arber333/Ampera-inverter-driver-interface/signals.jpg

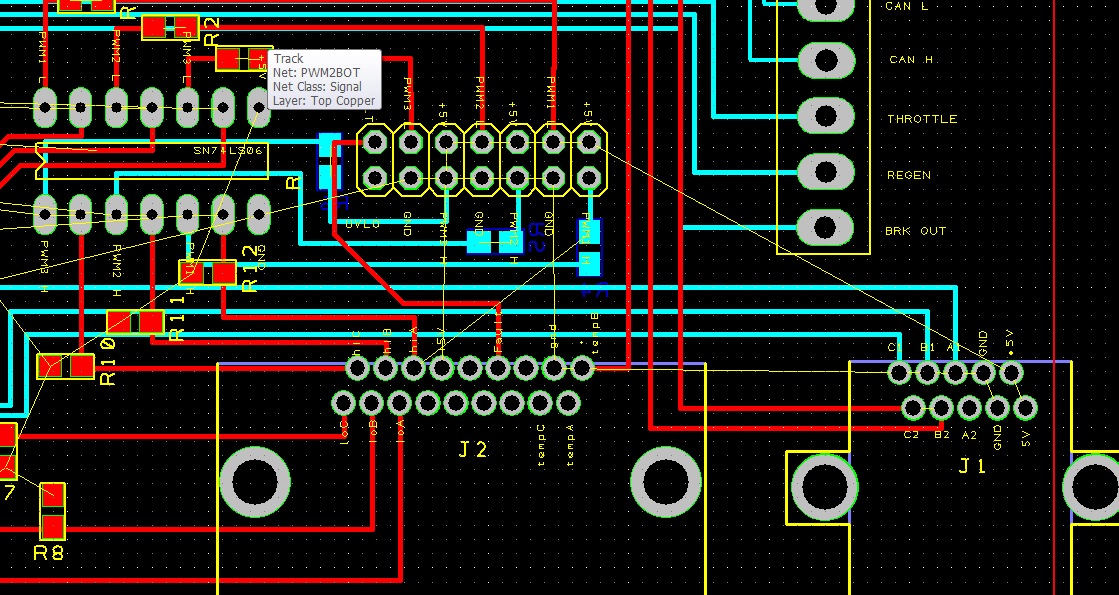
signals.jpg
