arber333/Ampera-inverter-driver-interface/signals2.jpg

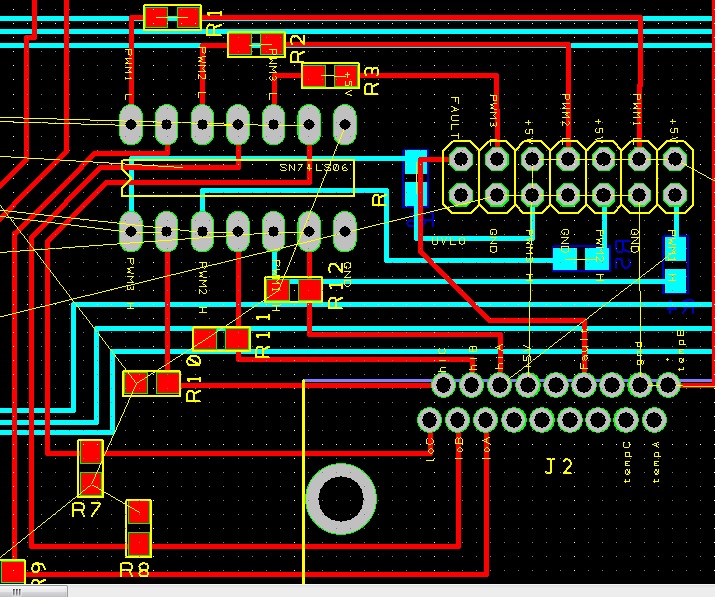
signals2.jpg
