arber333/Ampera-inverter-driver-interface/simple V2.jpg

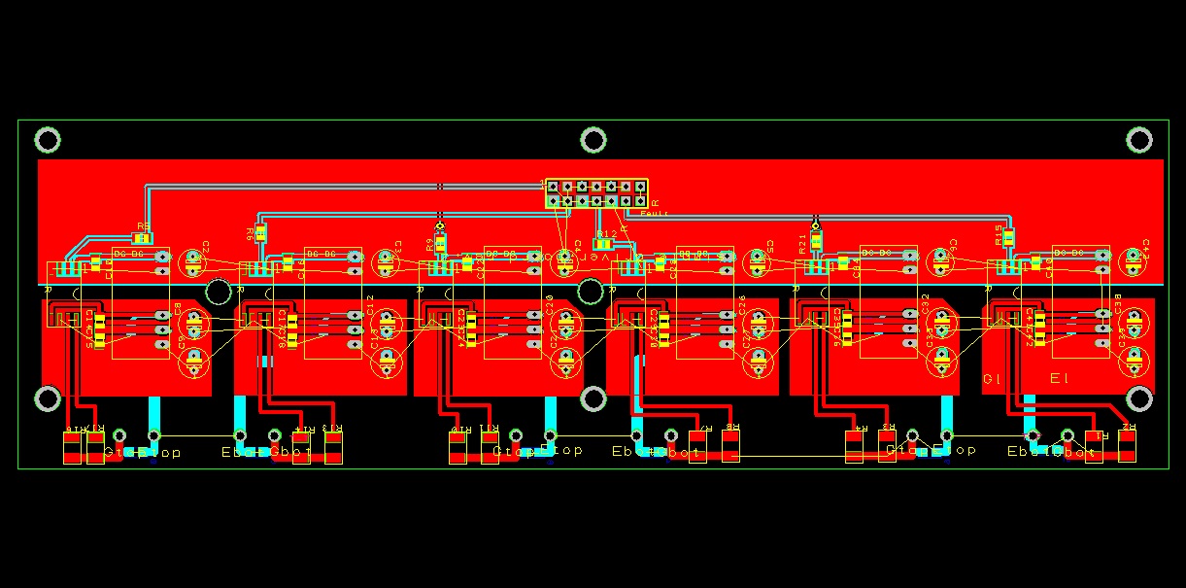
simple V2.jpg
