arber333/Ampera-inverter-driver-interface/translate PCB rev 2_3 - PCB.pdf

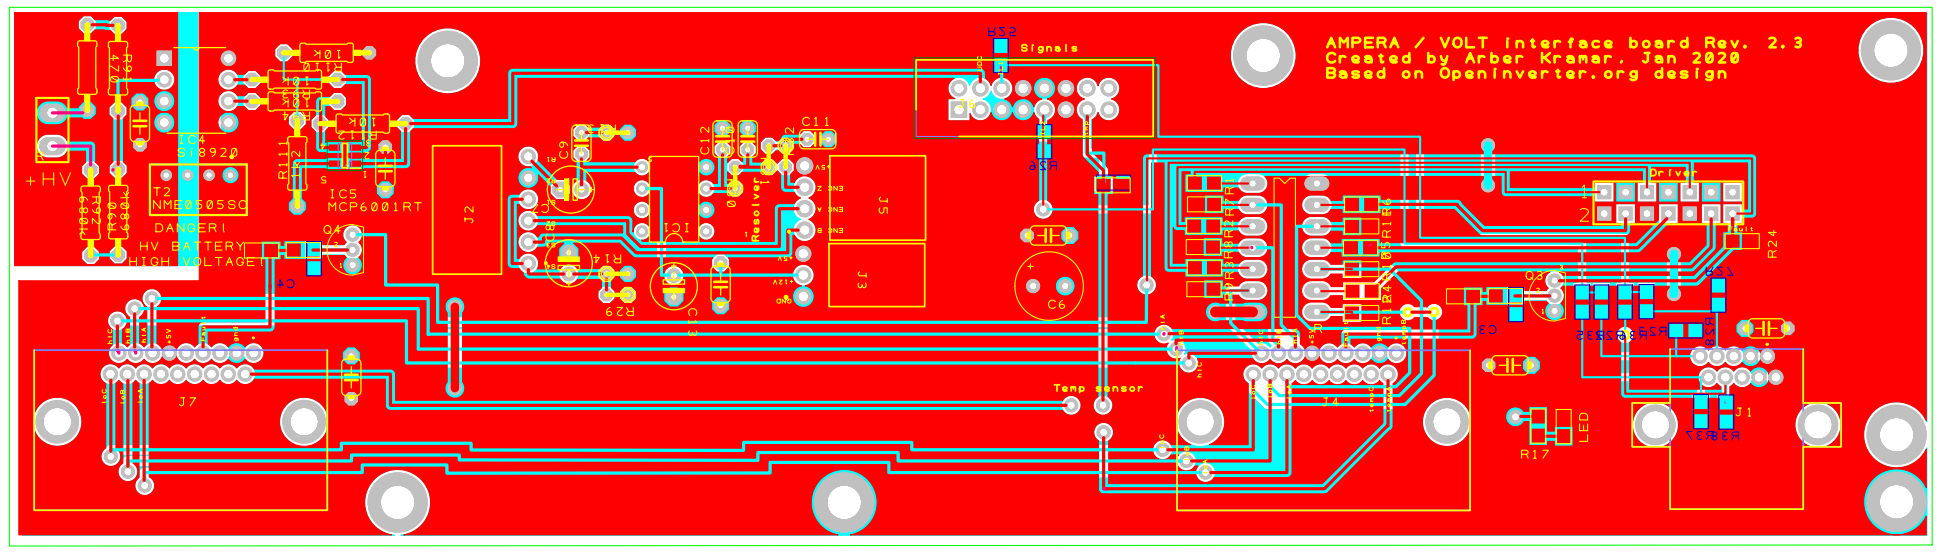
[picture p9: page 1]
