arber333/Ampera-inverter-driver-interface/lebowski interface board johannes - PCB.pdf

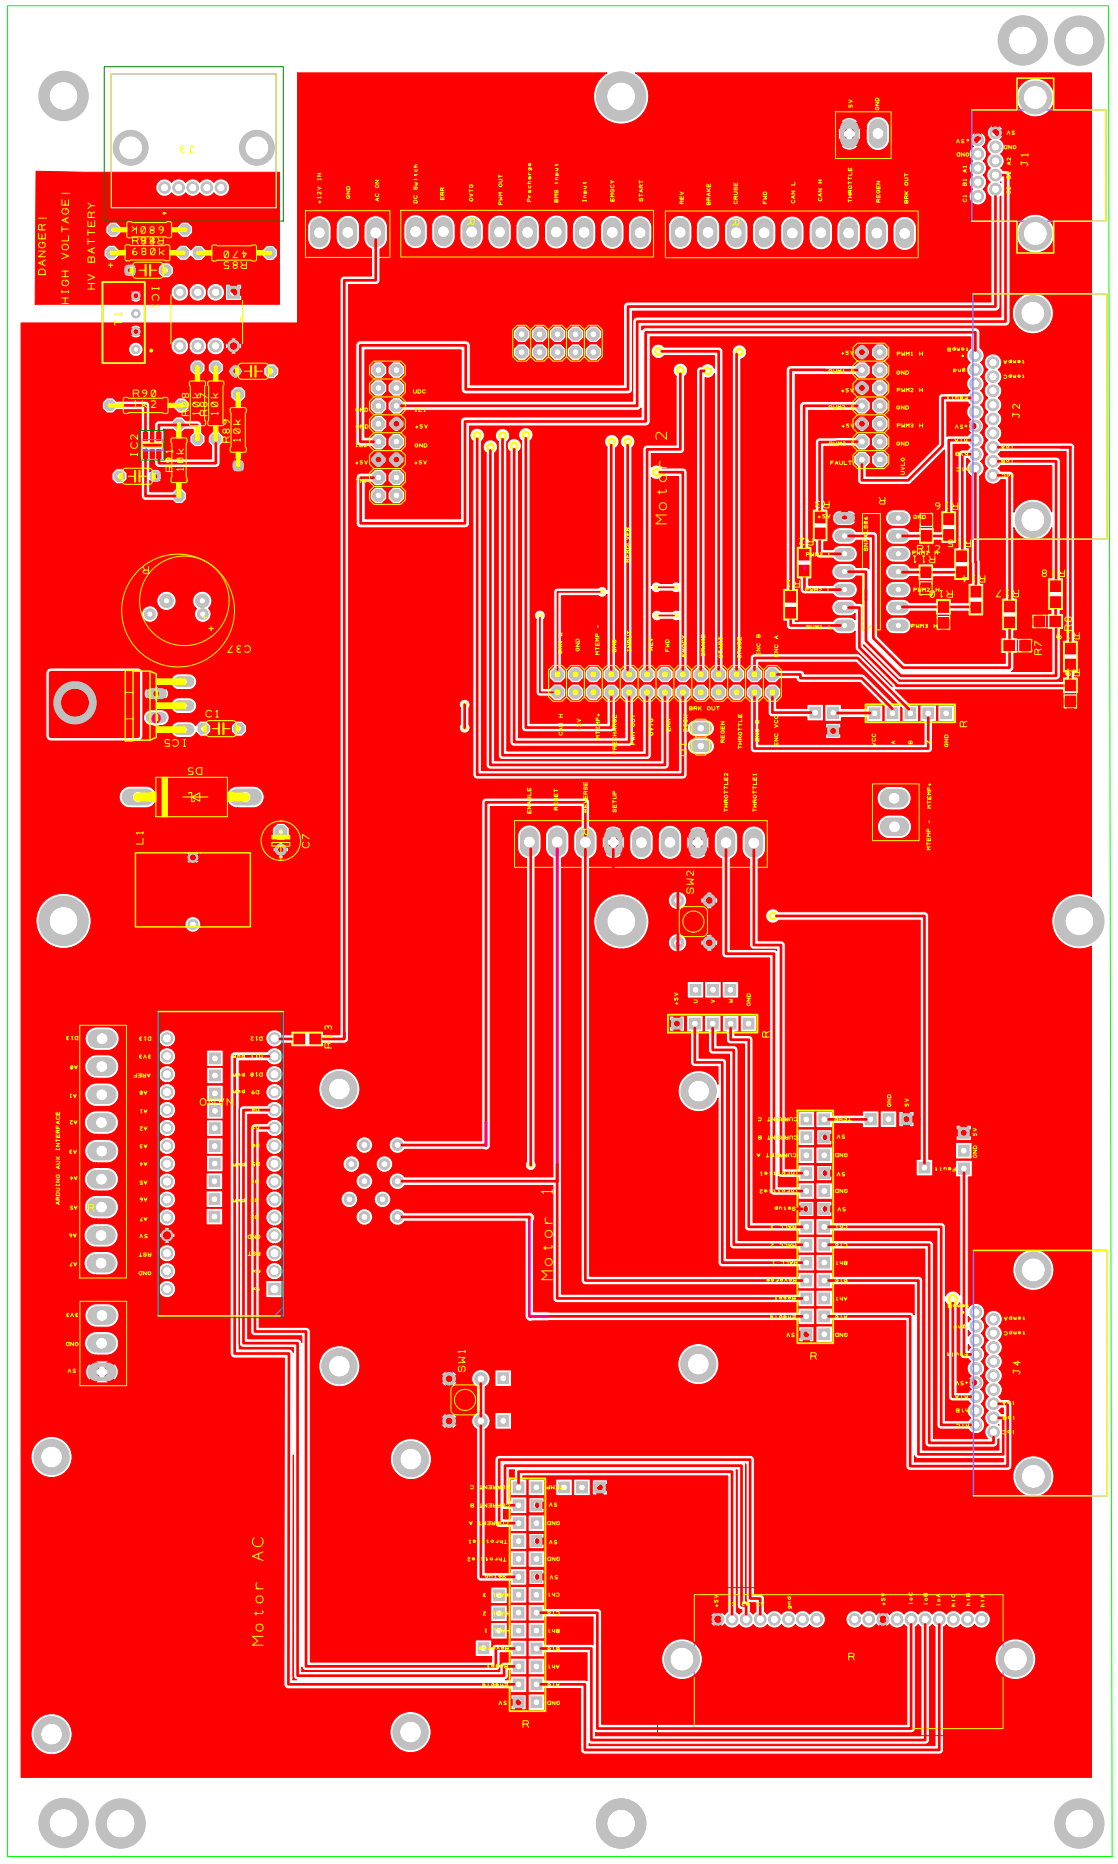
[picture p10: page 1]
