arber333/Ampera-inverter-driver-interface/lebowski interface board johannes - PCBb.pdf

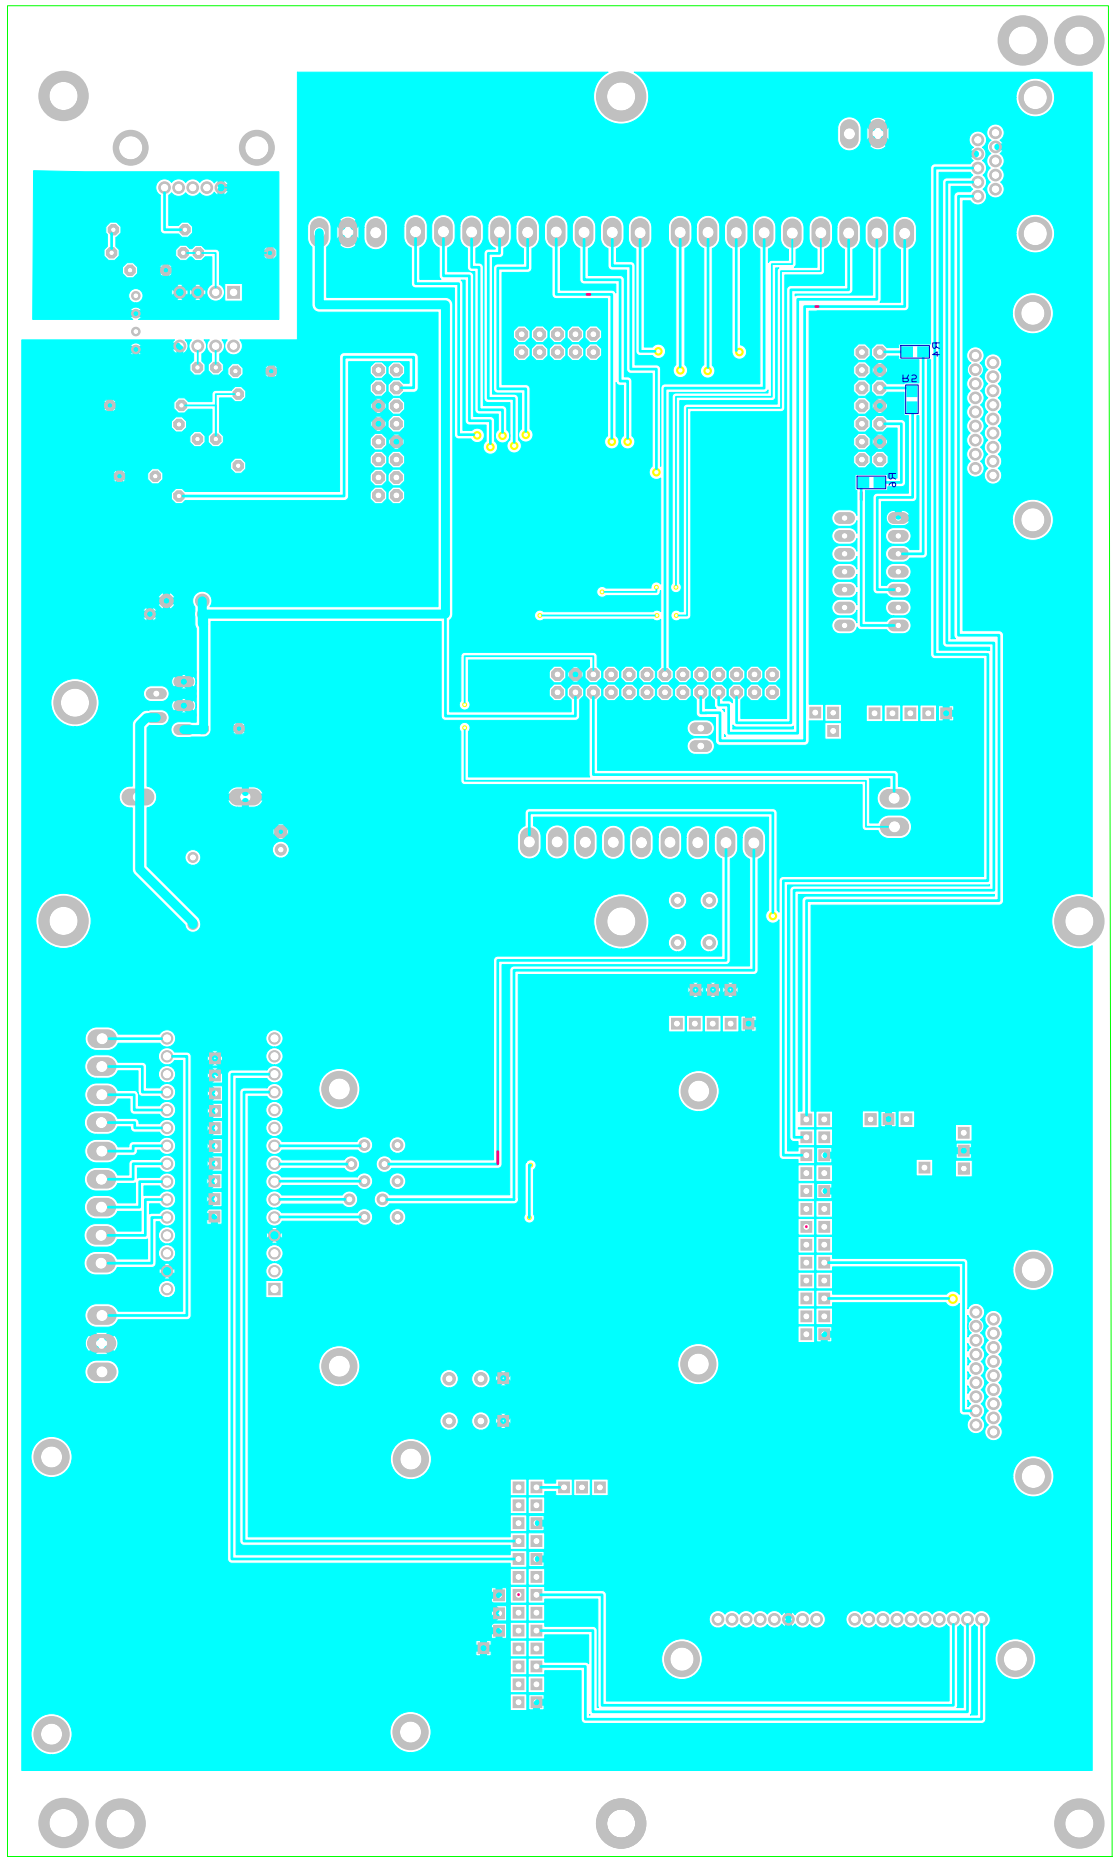
[picture p11: page 1]
