arber333/Ampera-inverter-driver-interface/(list of files, drawings)

Other design files:
lebowski interface board johannes.pcb
translate PCB rev 2.pcb
translate PCB rev 2_3.pcb
translate PCB rev 2_4.pcb
