arber333/Ampera-inverter-driver-interface/(commit log)

2020-04-26 Version Translate 2.3
    Board is a little larger and it incorporates both connectors which are used for driver and sensor board on Rev2 controler. I recommend this board if you decide to go that route.
    Additionally i included the inverter chip connected to BOTH driver connectors sou you can drive both IGBT bridges if you want to experiment.
    [translate PCB rev 2_3.pcb]
2020-05-23 translate PCB rev 2_3 file correction
    Some correction in parts identification.
    [translate PCB rev 2_3.pcb]
